Namdarkhodadad/BLDC-Motor/Final_Outcome/Both_PCBs.jpeg

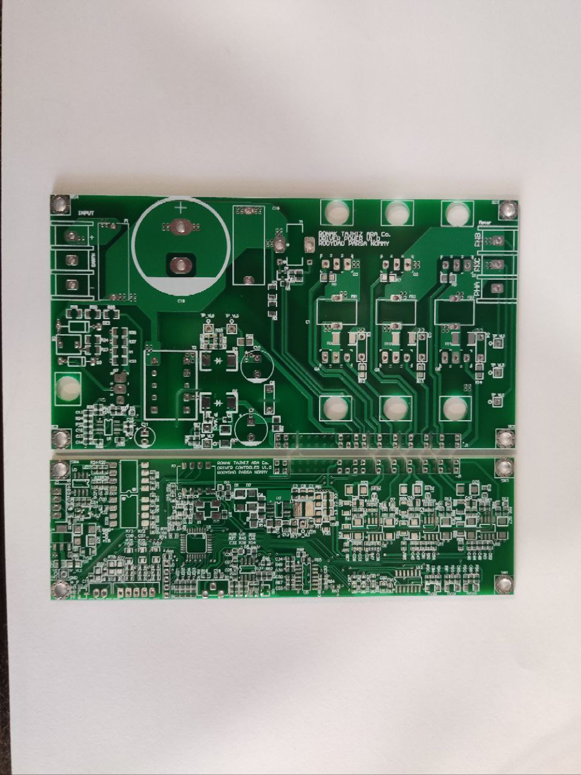
Final_Outcome/Both_PCBs.jpeg
