Namdarkhodadad/BLDC-Motor/Final_Outcome/Final_PCB.JPG

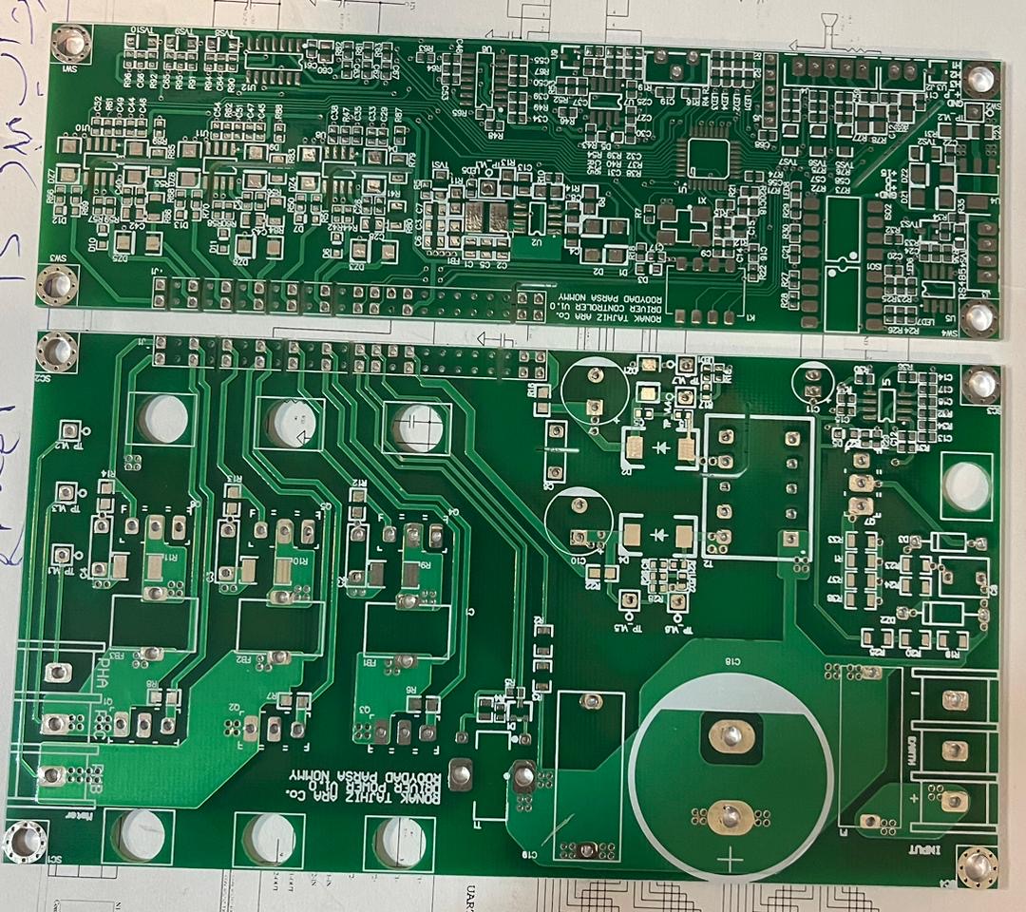
Final_Outcome/Final_PCB.JPG
