Namdarkhodadad/BLDC-Motor/Unofficial_Report.pdf

# Sensor-less brushless DC(BLDC) motor control project:

This summer, we worked on a motor control drive with which we could adjust the speed of a DC motor (could be used to run an air conditioner, a scooter wheel, and/or other flying gadgets such as a quadcopter). By using the word “Sensor-less”, we are referring to the fact that no sensors are to be used for detecting its rotor position. Instead we use the Back ElectroMotive Force (Or the BEMF) created by the motor itself to determine the rotor position. This will result in lower cost in mass production, as well as sufficient results, Having generated 3 BEMF signals (each 120° out of phase).
If we were to use sensors, or hall effect sensors, we would have to measure the density of a magnetic field around the device the entire time. These sensors have a present threshold and when the magnetic flux density exceeds this limit, the device is able to detect the magnetic field by generating an output called the hall voltage.
Back EMF signals are NOT synchronized with the hall effect sensor signals (shift of 30°).
For this part of the project we got help from this website presented below: https://simple-circuit.com/arduino-sensorless-bldc-motor-controller-esc/

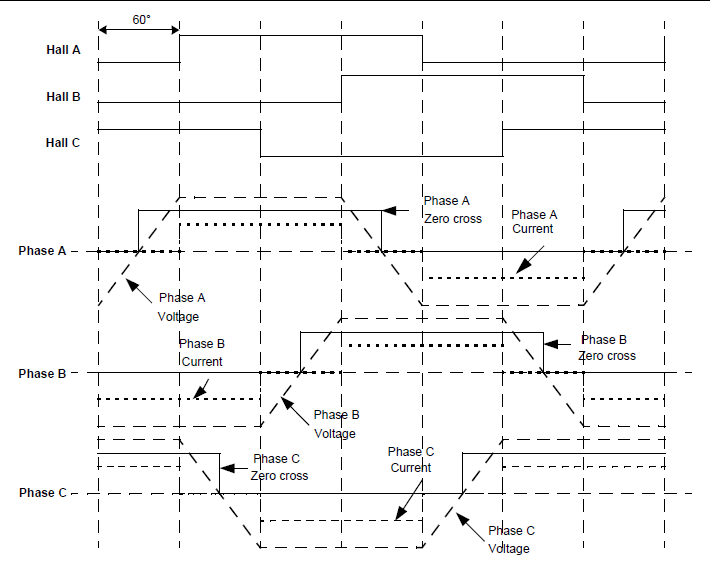
[picture p3: figure]

In every sequence, 2 windings are energized. One connected to positive and the other connected to negative while the third winding is to be left open (floating). The floating winding is applied for the zero-crossing detection. The combination of all 3 zero crossing points are used to generate the energizing sequence; Therefore we have 6 events demonstrated below:
Phase A Zero-Crossing : High to Low & Low to High.
Phase B Zero-Crossing : High to Low & Low to High.
Phase C Zero-Crossing : High to Low & Low to High.
In this part, we use comparators to detect the events. The comparator has 3 main terminals: 2 inputs (Positive and Negative) and one output;
Output is Logic-High if : Positive input > Negative input
And Logic-Low if : Positive input < Negative input

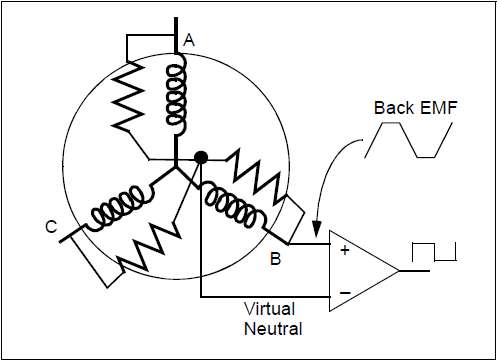
[picture p4: figure]

Now based on this website and this schematic below, we assembled the schematic using the Proteus application, applying the Arduino “.hex” code inside Proteus to see if it works.
Folder name: “simulation”
This is how the BLDC-DRIVER ended up to be:

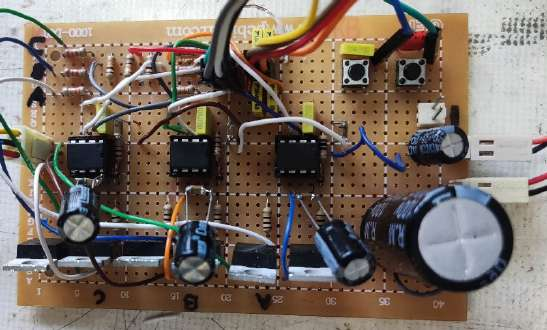
[picture p5: figure]

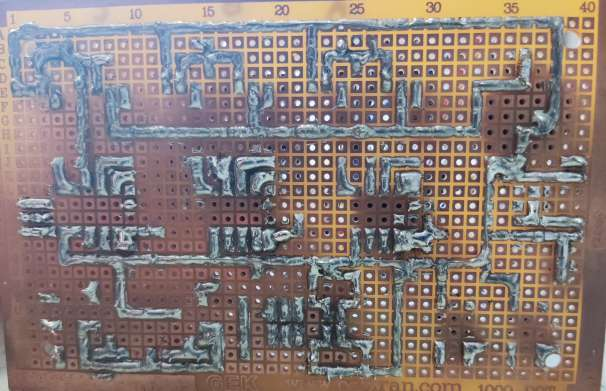
[picture p6: figure]

The scooter motor we are using:

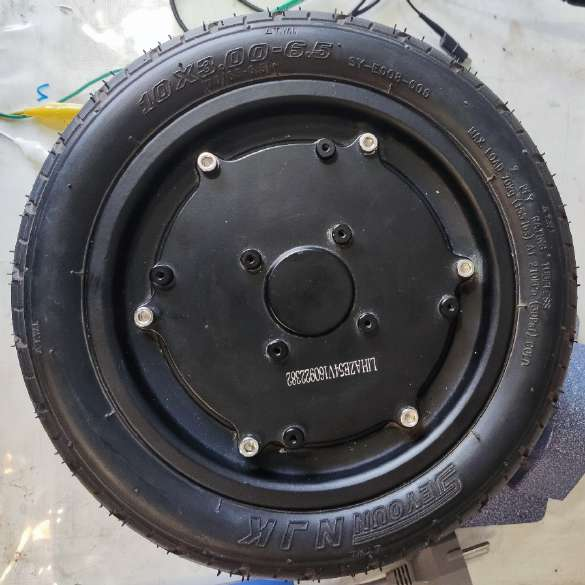
[picture p7: figure]

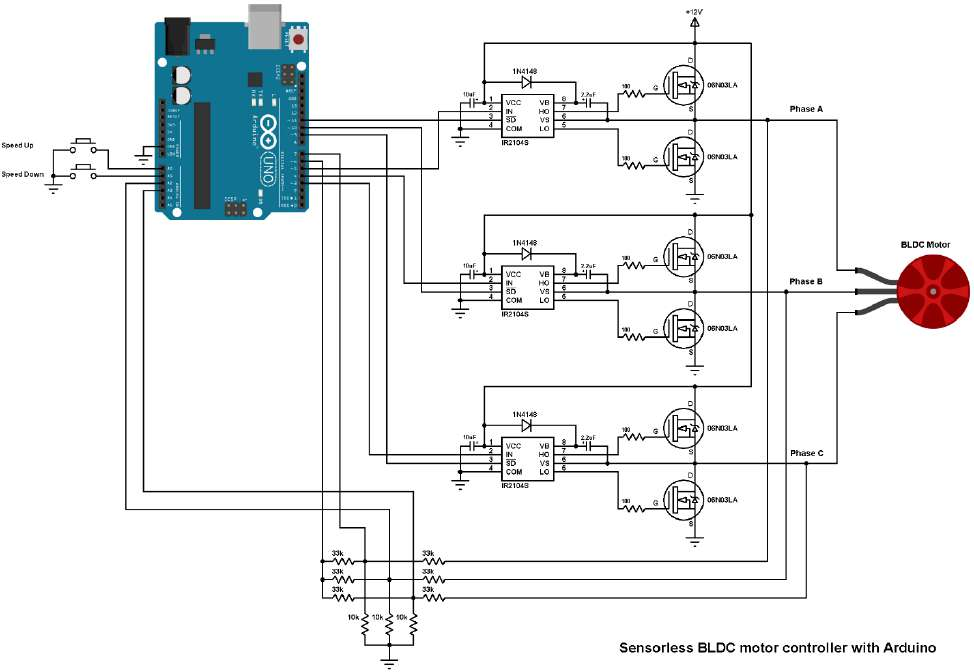
[picture p8: figure]

We used 3 IR2104 ICs in this Part of the project. But IR2104 has a down side compared to 2103; Based on the inner schematic and structure of each IC we can see that the 2104 has the High side input connected to DEAD TIME & SHOOT-THROUGH PREVENTION where as in 2103 both High side and Low side inputs are connected to DEAD TIME & SHOOT-THROUGH PREVENTION independently. In IR2101 and IR2102 however, there isn’t any DEAD TIME & SHOOT-THROUGH PREVENTION connected to the input:

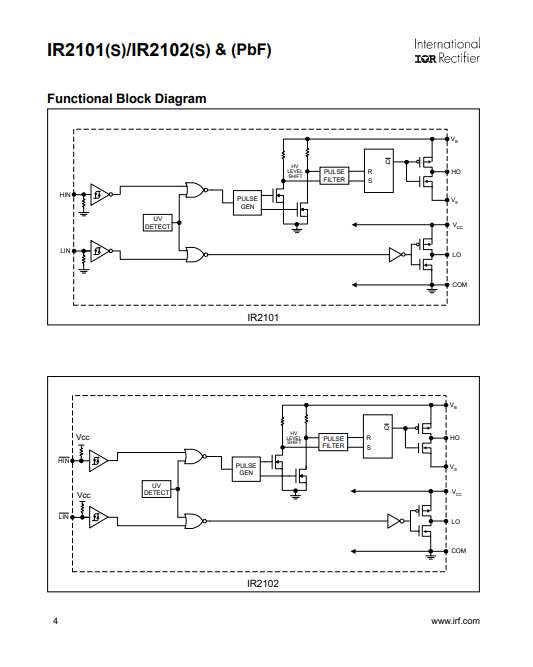
[picture p9: figure]
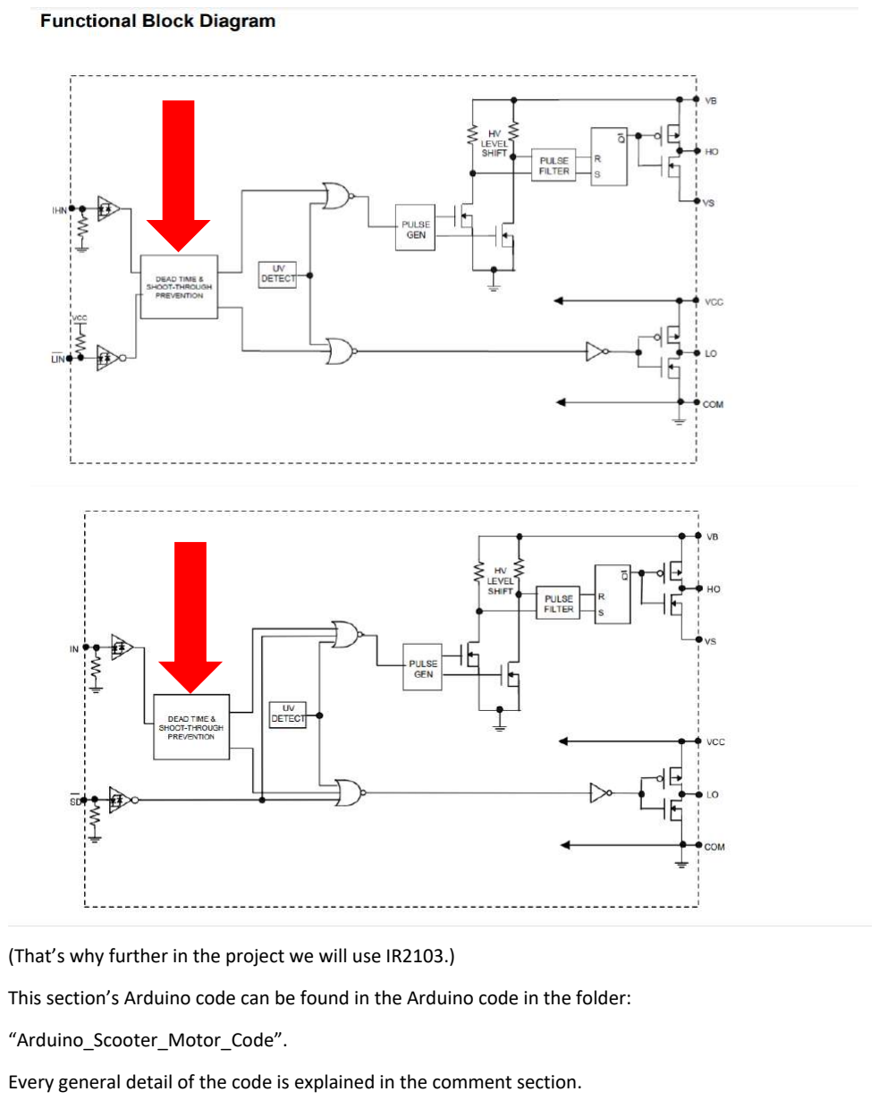
[picture p10: page 6]

(That’s why further in the project we will use IR2103.)
This section’s Arduino code can be found in the Arduino code in the folder: “Arduino_Scooter_Motor_Code”.
Every general detail of the code is explained in the comment section.

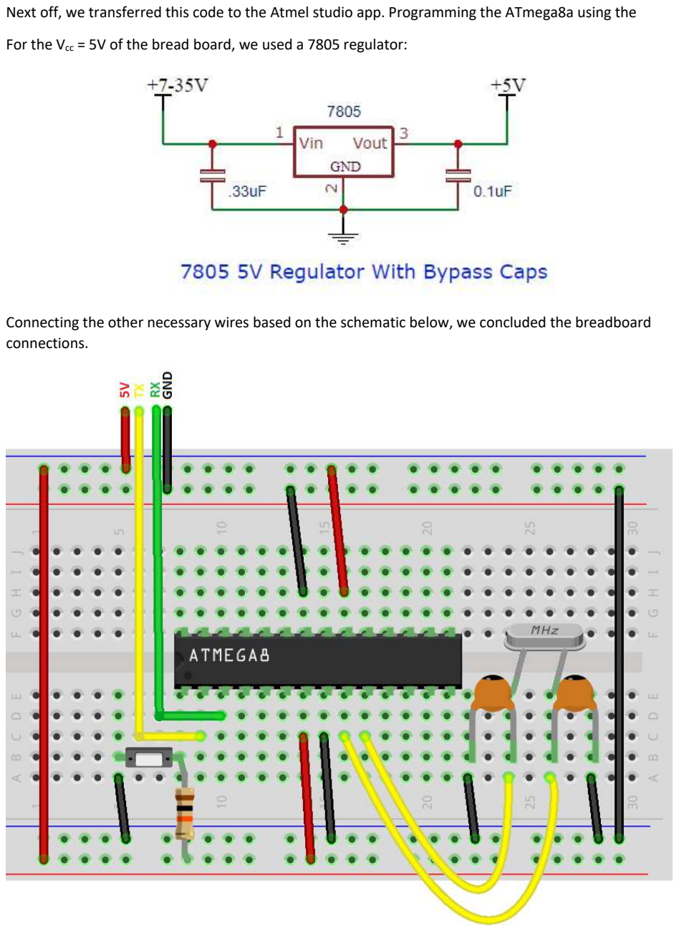
[picture p11: page 7]

Next off, we transferred this code to the Atmel studio app. Programming the ATmega8a using the For the Vcc = 5V of the bread board, we used a 7805 regulator:

Connecting the other necessary wires based on the schematic below, we concluded the breadboard connections.

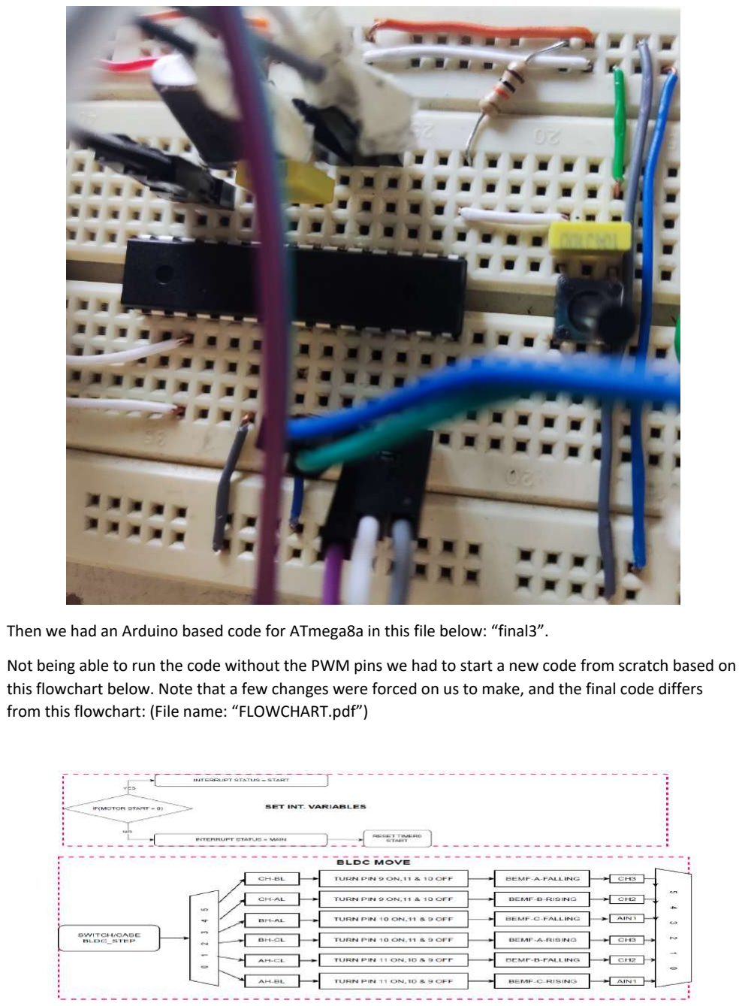
[picture p12: page 8]

Then we had an Arduino based code for ATmega8a in this file below: “final3”.
Not being able to run the code without the PWM pins we had to start a new code from scratch based on this flowchart below. Note that a few changes were forced on us to make, and the final code differs from this flowchart: (File name: “FLOWCHART.pdf”)

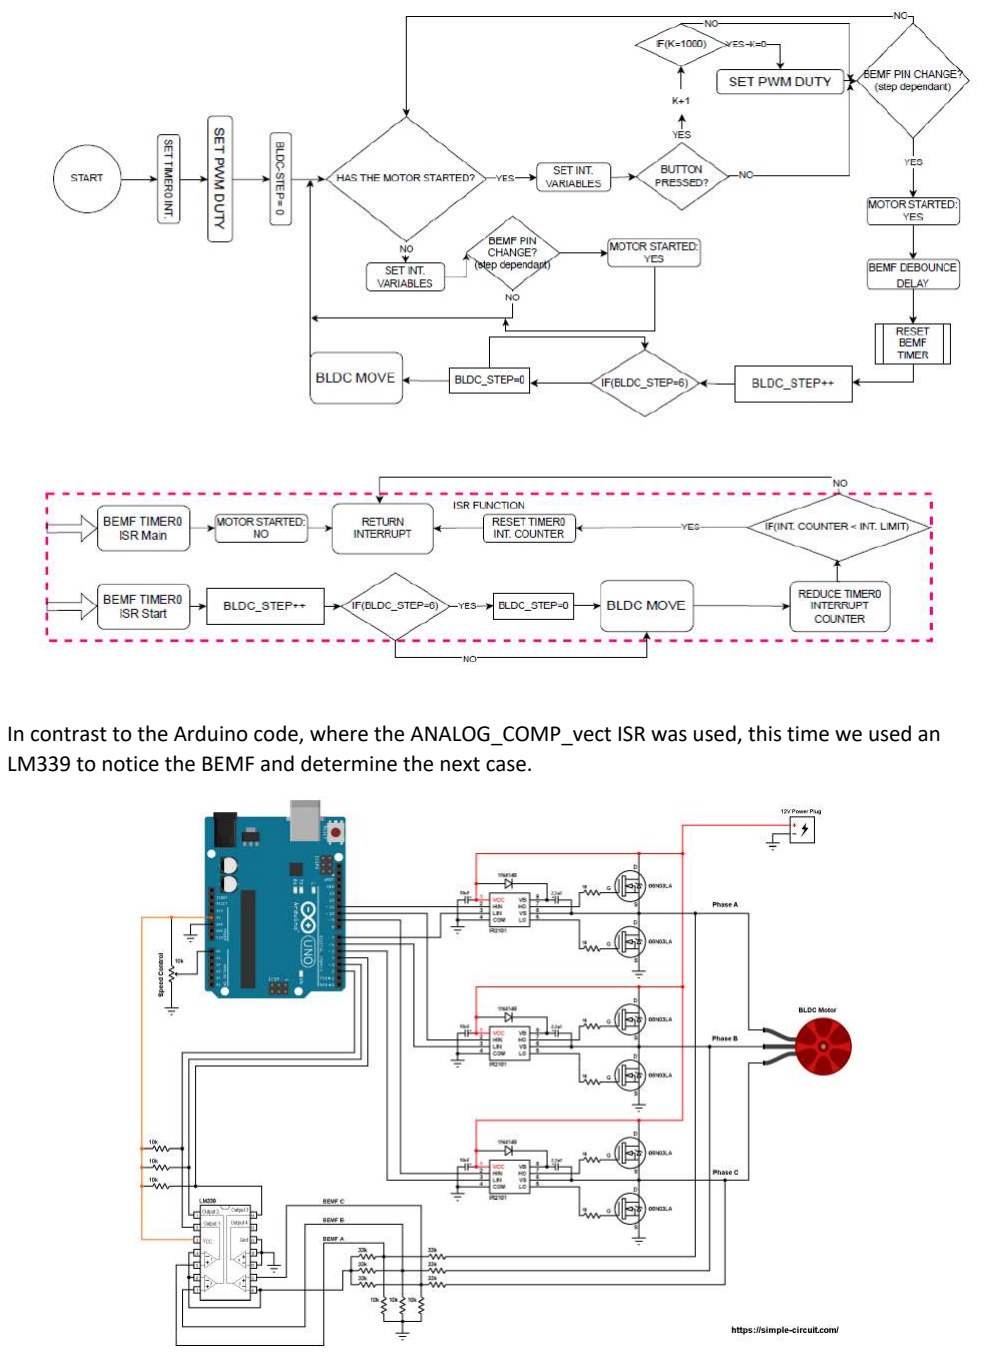
[picture p13: page 9]

In contrast to the Arduino code, where the ANALOG_COMP_vect ISR was used, this time we used an LM339 to notice the BEMF and determine the next case.

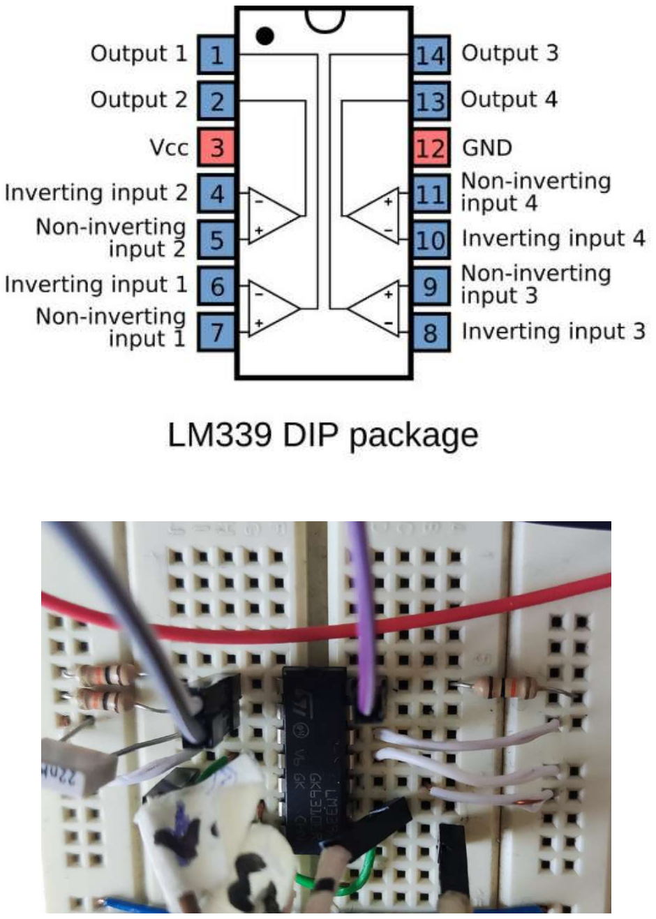
[picture p14: page 10]

In addition, for simplicity we only set one PWM port using the SN74HC132N NAND IC:

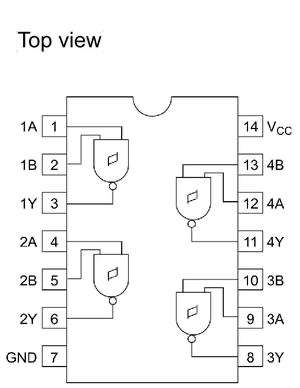
[picture p15: figure]
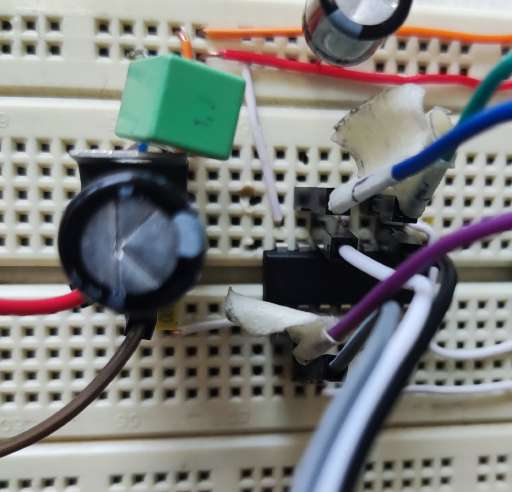
[picture p16: figure]

We then wrote a code using the BEMF of each case to predict the next stage of the motor motion. This is the table which helped us write this part:

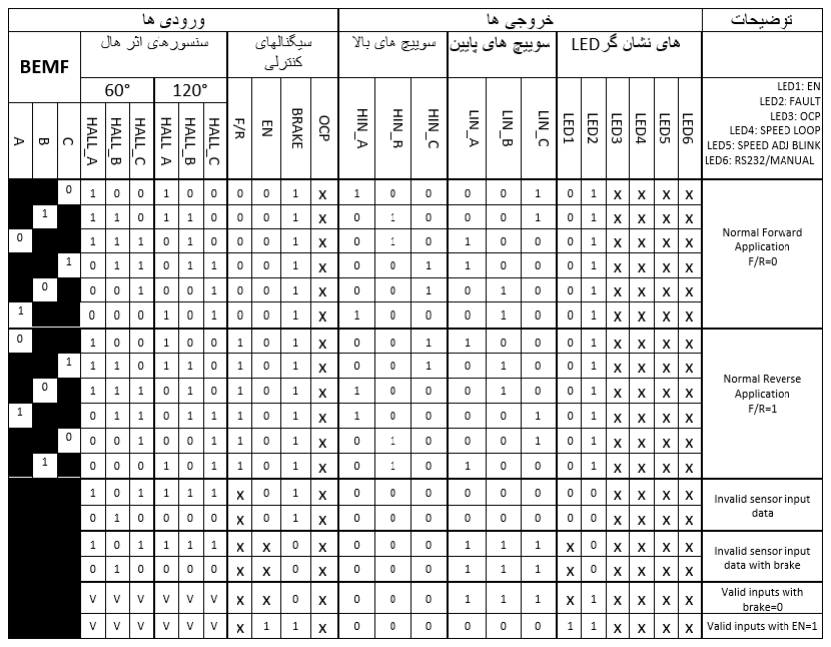
[picture p17: figure]

For the Hall Sensors, we extracted the table from the MC33035 Datasheet; However we derived the BEMF part ourselves.
File name: “ATmega8a_Final”
We explained every part of the code via comments throughout the entire code.

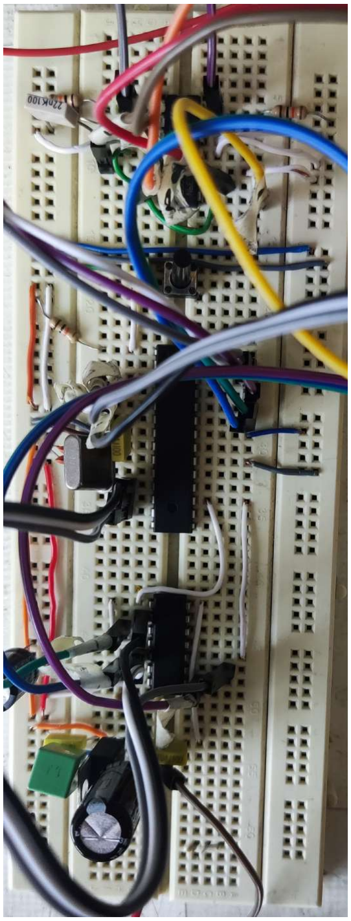
[picture p18: figure]
