Namdarkhodadad/BLDC-Motor/Final_Table.pdf

# تعرس لرتنک درب ھمانرب تراچوف و لمعلاروتسد سلشارب یاھروتوم

# :بلاطم تسرھف :رصتخم حرش

ینامز ھلصاف کی اب اھ پتسا ،روتوم رپتسا رد ھک توافت نیا اب تسا اھروتوم رپتسا لرتنک ھب ھیبش سلشارب یاھروتوم تعرس لرتنک رد یلو دنوشیم لامعا روتوم یاھزاف ھب صخشم سلشارب یاھروتوم دولزا لبق دنکیمن تکرح تخاونکی و فلتخم یاھتعرس اب روتور ھک .دوشیم لامعا یدعب )پتسا( نویساتاموک دیسر دوخ تیعقوم ھب روتور یتقو و دوشیم کچ روتور تیعقوم ،لودج زا پتسا رھ ندرک

## .دوشیم لرتنک دوشیم بصن روتوم نورد رد ھک لاھ رثا روسنس ددع ھس اب روتور تیعقوم لرتنک

## دوشیم لرتنک ددرگیم لامعازاف ھس لپ نییاپ یاھ چییوس ھب ھک PWM سلاپ اب مھ روتوم تعرس و

## :رادم یازجا و مارگاید کولب حرش

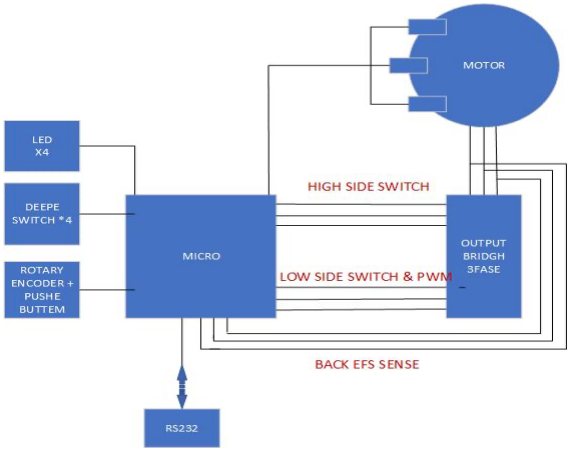
[picture p19: figure]

لاونم تروص ود ھب روتوم لرتنک تاعلاطا ھک تسا هدش هدافتسا 6RCT103F32STM لرتنکورکیم زا لااب مارگاید کولب رد قیرط زا ورکیم و دوشیم لاسرا نآ یارب 232RS-UART قیرط زا ای و )ردوکنا یراتور و ییاتراھچ چییوس DIP قیرط زا( 6 ددع ھس( لاھ رثا روسنس تروص ود ھب ار روتور تیعقوم تاعلاطا و دنکیم لرتنک ار روتوم زاف ھس لپ یارب یجورخ ھیاپ

## .دنکیم تفایرد )رگید یدورو نیپ ددع ھس( EMF BACK قیرط زا سلروسنس تروص ھب ایو )یدورو نیپ

.دنتسھ نداد شرازگ و ندناوخ لباق ورکیم یارب مھ ھیذغت ژاتلو و فلتخم یاھ زاف ژاتلو و زاف ھس لپ یلک نایرج

.دوشیم لاسرا زاف ھس لپ یارب ھناگادج تروص ھب ھک دوشیم لرتنک PWM ھیاپ کی قیرط زا مھ روتوم رود و رواتشگ

# :رازفا مرن درکلمع حرش

وط ھب هدرکن تفایرد ریالس تروپ زا ار یتامیظنت و ریالس هاگرد ھفقو ھک ینامز ات و دنکیم راک ھب عورش تراتسا یر زا سپ رلورتنک ورکیم ضرف شیپ ر لاسرا اھنآ قبط رب ار اھ یجورخ و هدرک تفایرد اھ یدورو زا ار تاعلاطا نییاپ لودج قبط رب ورکیم دم نیا رد.دنکیم راک ھب عورش Manual دم رد .دنکیم

## :یدورو یاھ نیپ

## یاھ یدورو )فلا ییاتراھچ چییوس پید

1) R/F ھک یتروص رد و دنکیم تکرح درگ تعاس تھج رد روتوم دشاب رفص ھک یتروص رد و تسا روتوم تکرح تھج هدننک نییعت نیپ نیا : هدش صخشم لودج رد دروم ود رد ھک دخرچیم درگ تعاس داپ تھج رد روتوم دشاب کی ربارب
2) SENSORLESS/HALL لاھ رثا یاھروسنس قیرط زا ار روتور تیعقوم تاعلاطا ورکیم نیپ نیا ندوب کی تروص رد : C,B,A دنکیم تفایرد تاعلاطا و دنکیم راک سل روسنس دم رد ورکیم دشاب رفص نیپ نیا ھک ینامز و دنکیم دول ار اھ یجورخ لودج قبط رب و )کیتامش ھب عوجر(
یاھ ھیاپ قیرط زا ار روتور تیعقوم C,B,A EMF BACK .دنکیم تفایرد )کیتامش ھب عوجر(
3) 120/60 SENSOR شیارآ ینعم ھب ورکیم یارب نیپ نیا نوب کی دنکیمراک لاھ رثا روسنس دم رد ورکیم ھک ینامز : 60 رثا یاھروسنس ھجرد شیارآ ینعمھب نآ ندوب رفص و لاھ 120 .تسا لاھ رثا یاھروسنس ھجرد

## یساش یاراد ردوکنا یراتور یاھ یدورو )ب

( 1

| | تاحیضوت اھ یجورخ اھ یدورو
BEMF | لاھ رثا یاھروسنس | یلرتنک | رگ ناشن یاھ LED نییاپ یاھ چییوس لااب یاھ چییوس یاھلانگیس | LED1: EN
60° | 120° | | | | LED2: FAULT LED3: OCP LED4: SPEED LOOP LED5: SPEED ADJ BLINK LED6: RS232/MANUAL

LED1

LED2
LED3

LED4

LED5

LED6

## HIN_A HIN_B HIN_C

LIN_A
LIN_B
LIN_C
OCP

## BRAKE

F/R
EN

## HALL_A

## HALL_B

## HALL_C

## HALL_A HALL_B HALL_C

A
B
C
| 1 | 0 | 0 | 1 | 0 | 0 | 0 | 0 | 1 | x | 1 | 0 | 0 | 0 | 0 | 1 | 0 | 1 | x | x | x | x ⁰ | Normal Forward Application F/R=0
| 1 | 1 | 0 | 1 | 1 | 0 | 0 | 0 | 1 | x | 0 | 1 | 0 | 0 | 0 | 1 | 0 | 1 | x | x | x | x ¹
| 1 | 1 | 1 | 0 | 1 | 0 | 0 | 0 | 1 | x | 0 | 1 | 0 | 1 | 0 | 0 | 0 | 1 | x | x | x | x ⁰
| 0 | 1 | 1 | 0 | 1 | 1 | 0 | 0 | 1 | x | 0 | 0 | 1 | 1 | 0 | 0 | 0 | 1 | x | x | x | x ¹
| 0 | 0 | 1 | 0 | 0 | 1 | 0 | 0 | 1 | x | 0 | 0 | 1 | 0 | 1 | 0 | 0 | 1 | x | x | x | x ⁰
0 | | 0 | 0 | 1 | 0 | 1 | 0 | 0 | 1 | x | 1 | 0 | 0 | 0 | 1 | 0 | 0 | 1 | x | x | x | x ¹
| 1 | 0 | 0 | 1 | 0 | 0 | 1 | 0 | 1 | x | 0 | 0 | 1 | 1 | 0 | 0 | 0 | 1 | x | x | x | x ⁰ | Normal Reverse Application F/R=1
| 1 | 1 | 0 | 1 | 1 | 0 | 1 | 0 | 1 | x | 0 | 0 | 1 | 0 | 1 | 0 | 0 | 1 | x | x | x | x ¹
| 1 | 1 | 1 | 0 | 1 | 0 | 1 | 0 | 1 | x | 1 | 0 | 0 | 0 | 1 | 0 | 0 | 1 | x | x | x | x ⁰
| 0 | 1 | 1 | 0 | 1 | 1 | 1 | 0 | 1 | x | 1 | 0 | 0 | 0 | 0 | 1 | 0 | 1 | x | x | x | x ¹
| 0 | 0 | 1 | 0 | 0 | 1 | 1 | 0 | 1 | x | 0 | 1 | 0 | 0 | 0 | 1 | 0 | 1 | x | x | x | x ⁰
| 0 | 0 | 0 | 1 | 0 | 1 | 1 | 0 | 1 | x | 0 | 1 | 0 | 1 | 0 | 0 | 0 | 1 | x | x | x | x ¹
| 1 | 0 | 1 | 1 | 1 | 1 | x | 0 | 1 | x | 0 | 0 | 0 | 0 | 0 | 0 | 0 | 0 | x | x | x | x | Invalid sensor input data
| 0 | 1 | 0 | 0 | 0 | 0 | x | 0 | 1 | x | 0 | 0 | 0 | 0 | 0 | 0 | 0 | 0 | x | x | x | x
| 1 | 0 | 1 | 1 | 1 | 1 | x | x | 0 | x | 0 | 0 | 0 | 1 | 1 | 1 | x | 0 | x | x | x | x | Invalid sensor input data with brake
| 0 | 1 | 0 | 0 | 0 | 0 | x | x | 0 | x | 0 | 0 | 0 | 1 | 1 | 1 | x | 0 | x | x | x | x
| | V | V | V | V | V | x | x | 0 | x | 0 | 0 | 0 | 1 | 1 | 1 | x | 1 | x | x | x | x | Valid inputs with brake=0 V
| V | V | V | V | V | V | x | 1 | 1 | x | 0 | 0 | 0 | 0 | 0 | 0 | 1 | 1 | x | x | x | x | Valid inputs with EN=1

IR2103
HIN | LIN | OUTH | OUTL
0 | 0 | 0 | 1
0 | 1 | 0 | 0
1 | 0 | 0 | 0
1 | 1 | 1 | 0

IR2104
IN | SD | OUTH | OUTL
0 | 0 | 0 | 0
0 | 1 | 0 | 1
1 | 0 | 0 | 0
1 | 1 | 1 | 0

## IN & SD(IR2104) TO HIN & LIN(IR2103)

IR2104 INPUT | IR2103 INPUT
IN | SD | HIN | LIN
0 | 0 | 0 (1) | 1 (0)
0 | 1 | 0 | 0
1 | 0 | 1 (0) | 0 (1)
1 | 1 | 1 | 1
