Namdarkhodadad/BLDC-Motor/Final_Outcome/Final_Motor.jpg

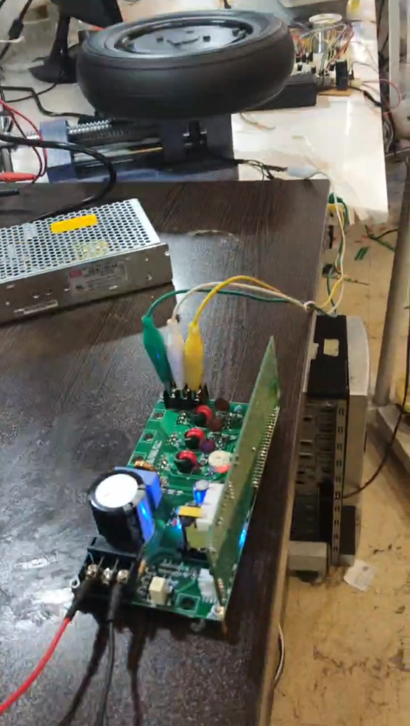
Final_Outcome/Final_Motor.jpg
