Namdarkhodadad/BLDC-Motor/Final_Outcome/Names_invovled.JPG

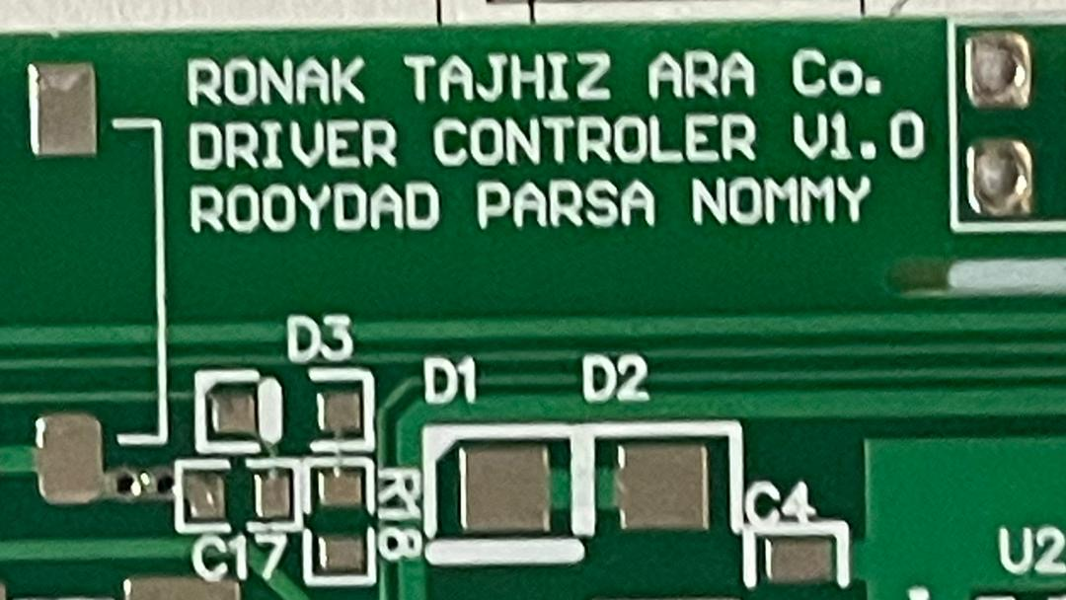
Final_Outcome/Names_invovled.JPG
