Namdarkhodadad/BLDC-Motor/(list of files, drawings)

Other design files:
simulation/BLDC_sensorless.pdsprj
simulation/Project Backups/BLDC_sensorless [20230622, 15-15-35].pdsprj
simulation/Project Backups/BLDC_sensorless [20230802, 17-56-11].pdsprj
