Namdarkhodadad/BLDC-Motor/Final_Outcome/STK500_kit.jpeg

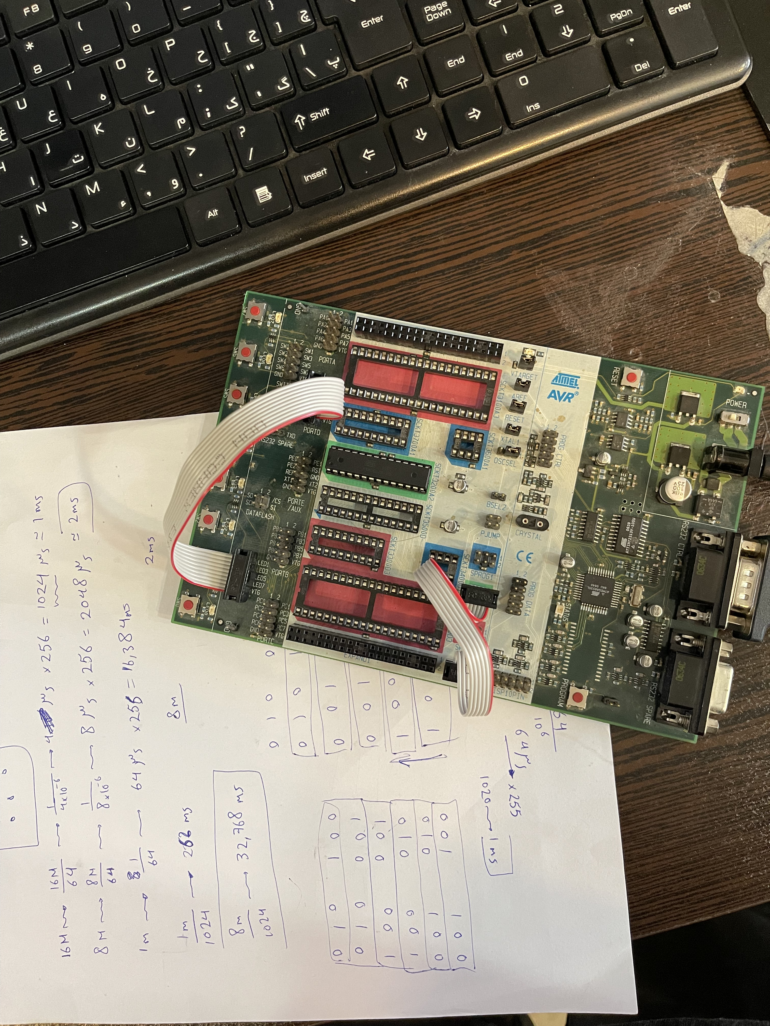
Final_Outcome/STK500_kit.jpeg
